rusefi/hellen-miata-NB1/README.md

# Hellen NB1 Miata

Issues are tracked publicly at https://github.com/rusefi/hellen-NB1-issues

[User Documentation](https://github.com/rusefi/rusefi/wiki/Hellen-NB1)

https://docs.google.com/spreadsheets/d/19Mc_QA4MTJAY1hUR4UMexbdGiqNpH4JARKxWm1VD5KA
