rusefi/hellen-miata-NB1/boards/hellen64_NB1-a/board/hellen64_NB1-a.png

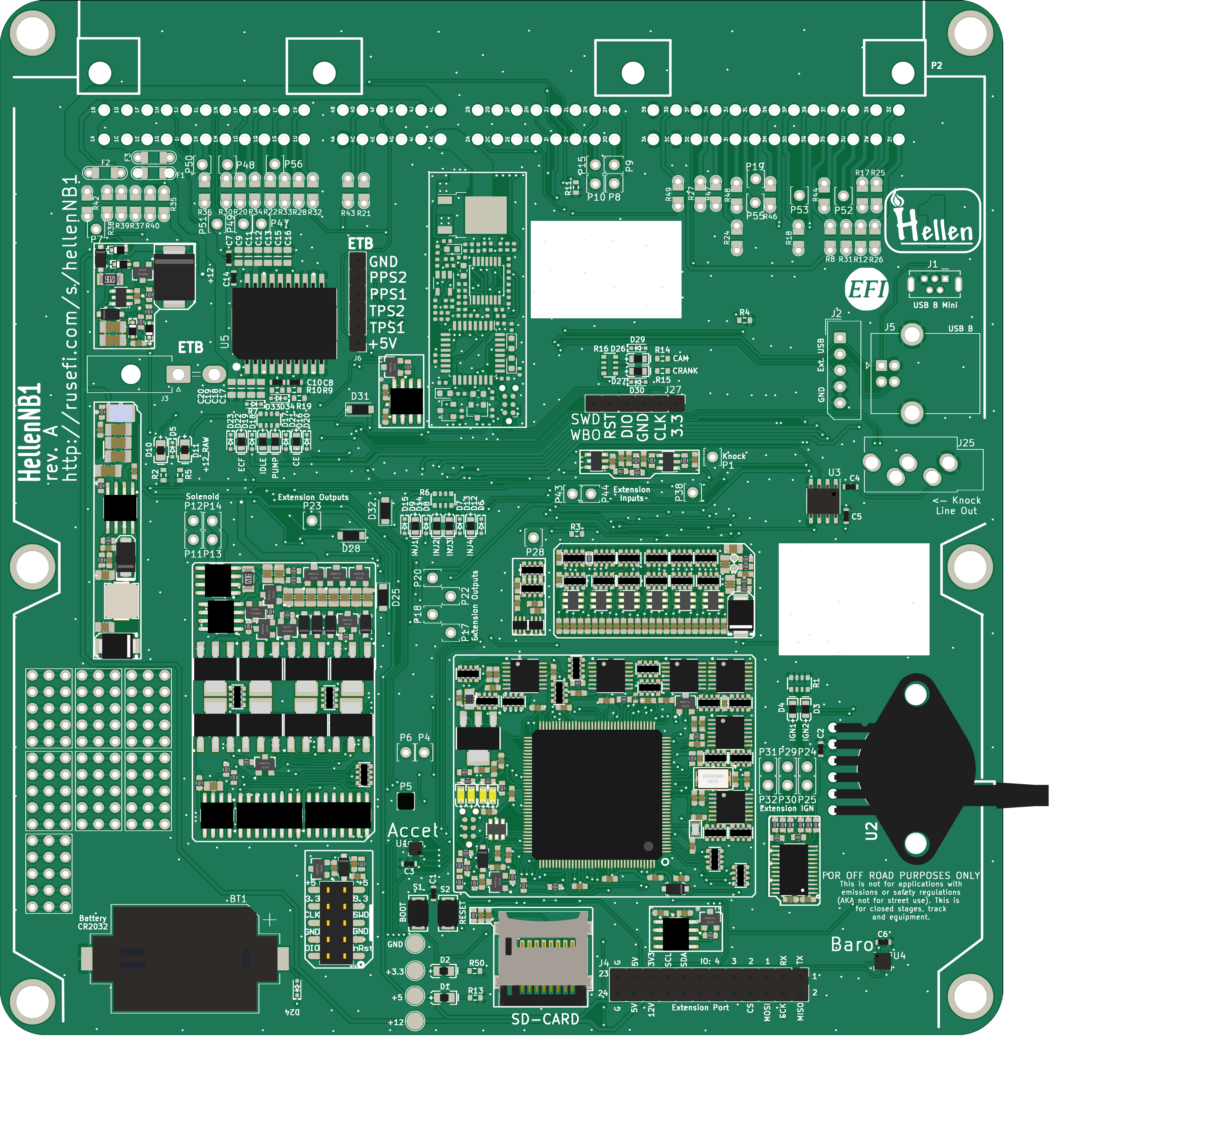
boards/hellen64_NB1-a/board/hellen64_NB1-a.png
