rusefi/hellen-miata-NB1/boards/hellen64_NB1-a/board/misc/hellen64_NB1-a-outline.png

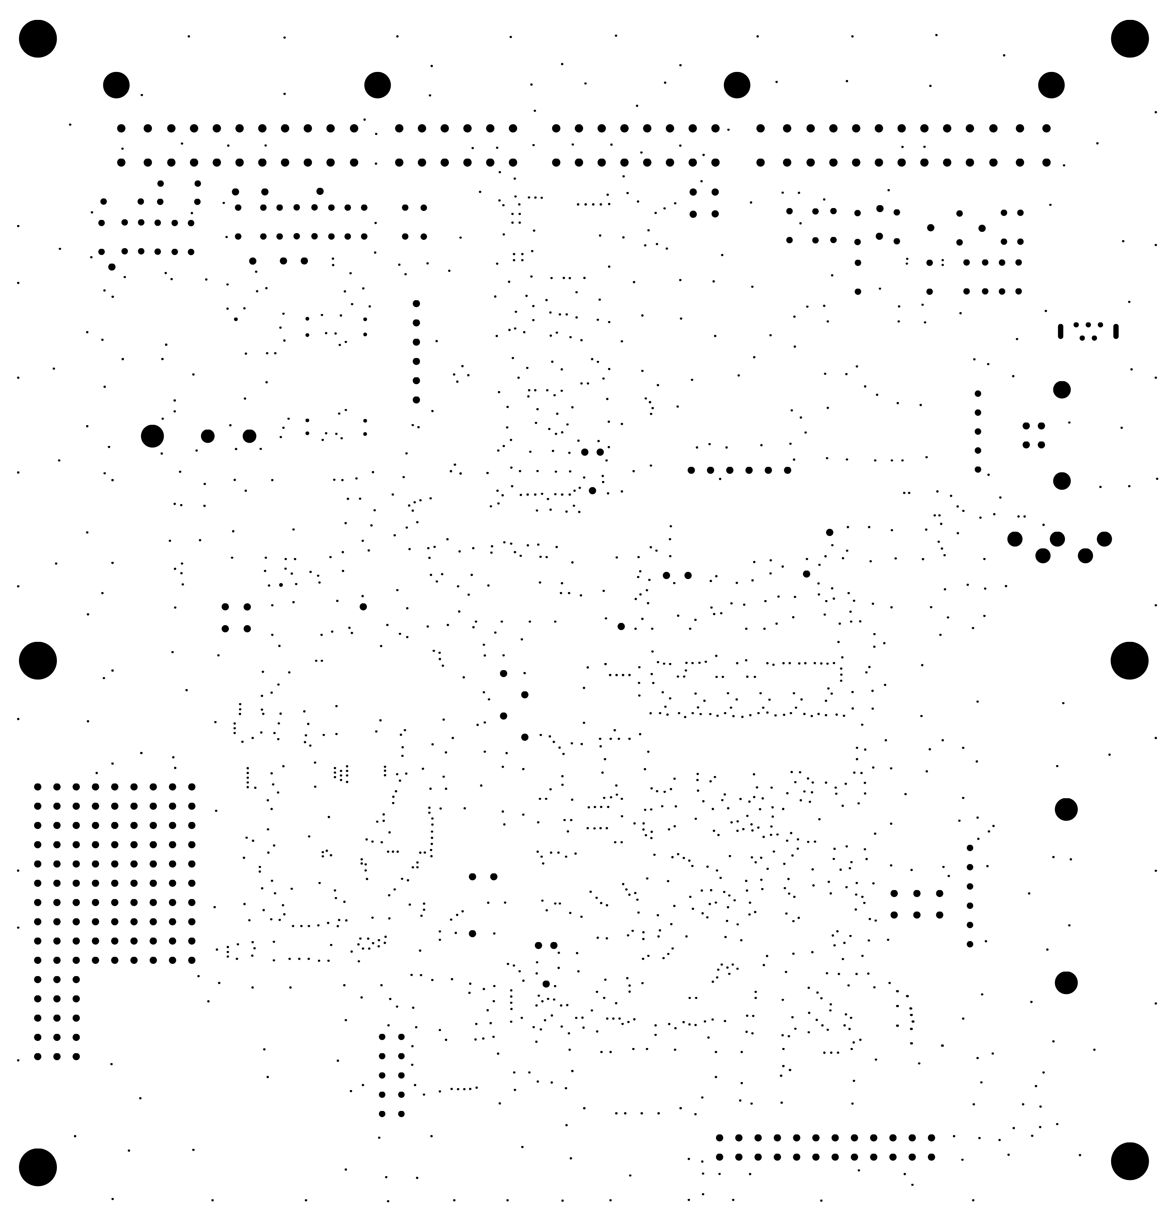
boards/hellen64_NB1-a/board/misc/hellen64_NB1-a-outline.png
