rusefi/hellen-miata-NB1/boards/hellen64_NB1-c/board/hellen64_NB1-c-schematic.pdf

nReset | W5 SWDIO | W6 SWCLK | W7 V33_OUT | W8 M12 Module-wbo-0.3 C²⁰ | 10u | GND
IGN8 | V1 V33 | V10

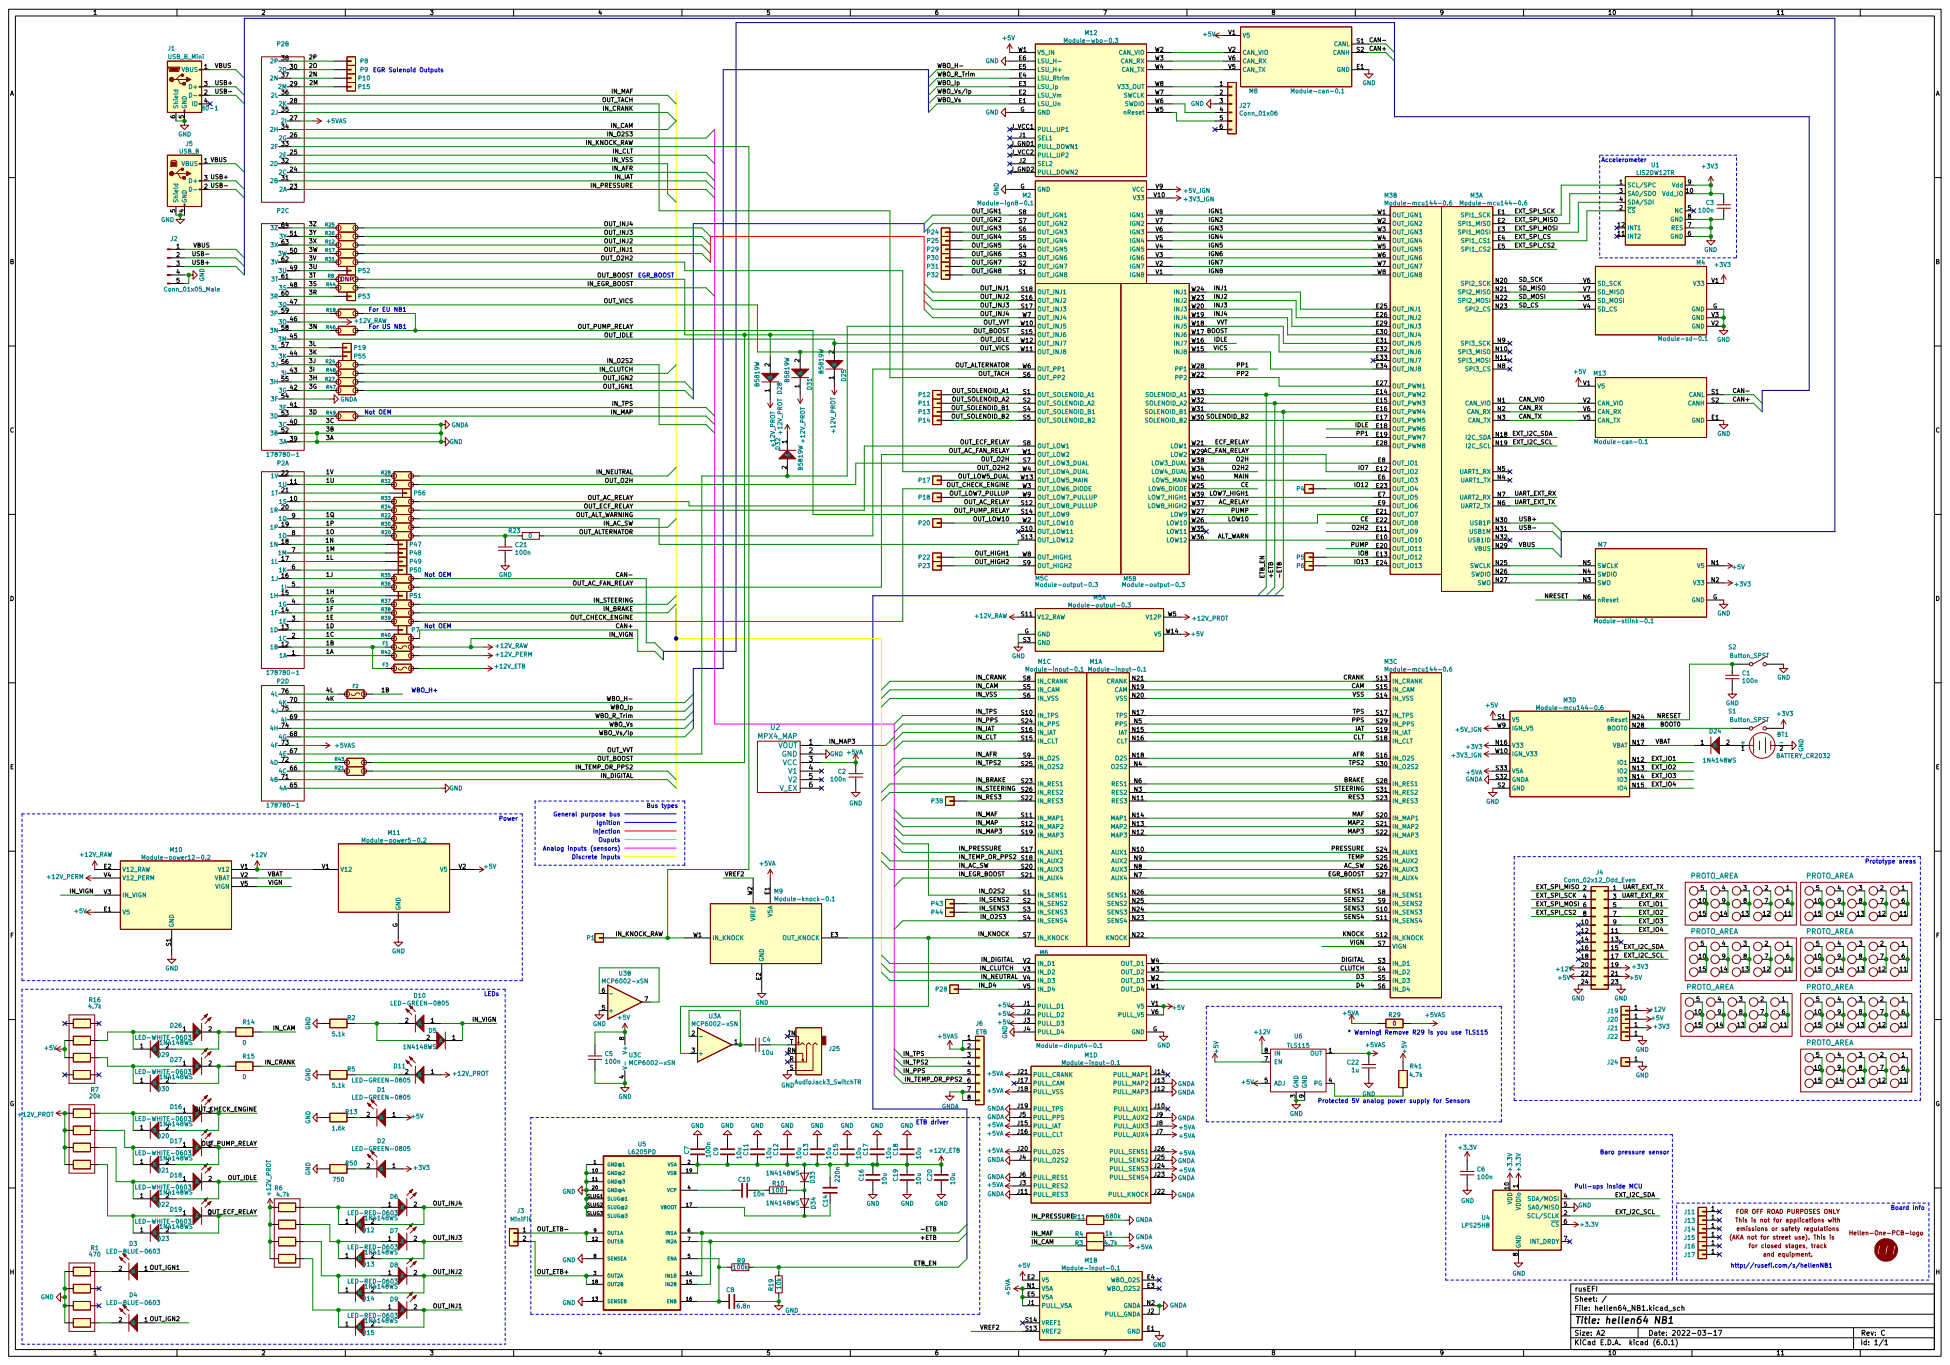
[picture p6: page 1]

For EU NB1 For US NB1 EGR Solenoid Outputs

VBUS USB-USB+ USB- USB+

EXT_I2C_SCL UART_EXT_RX UART_EXT_TX USB+ USB- VBUS MAF MAP2 MAP3 PRESSURE

* Warning! Remove R29 is you use TLS115

This is not for applications with R7

Pull-ups inside MCU

Hellen-One-PCB-logo GND

for closed stages, track FOR OFF ROAD PURPOSES ONLY

emissions or safety regulations
(AKA not for street use). This is

File: hellen64_NB1.kicad_sch Sheet: / rusEFI GND

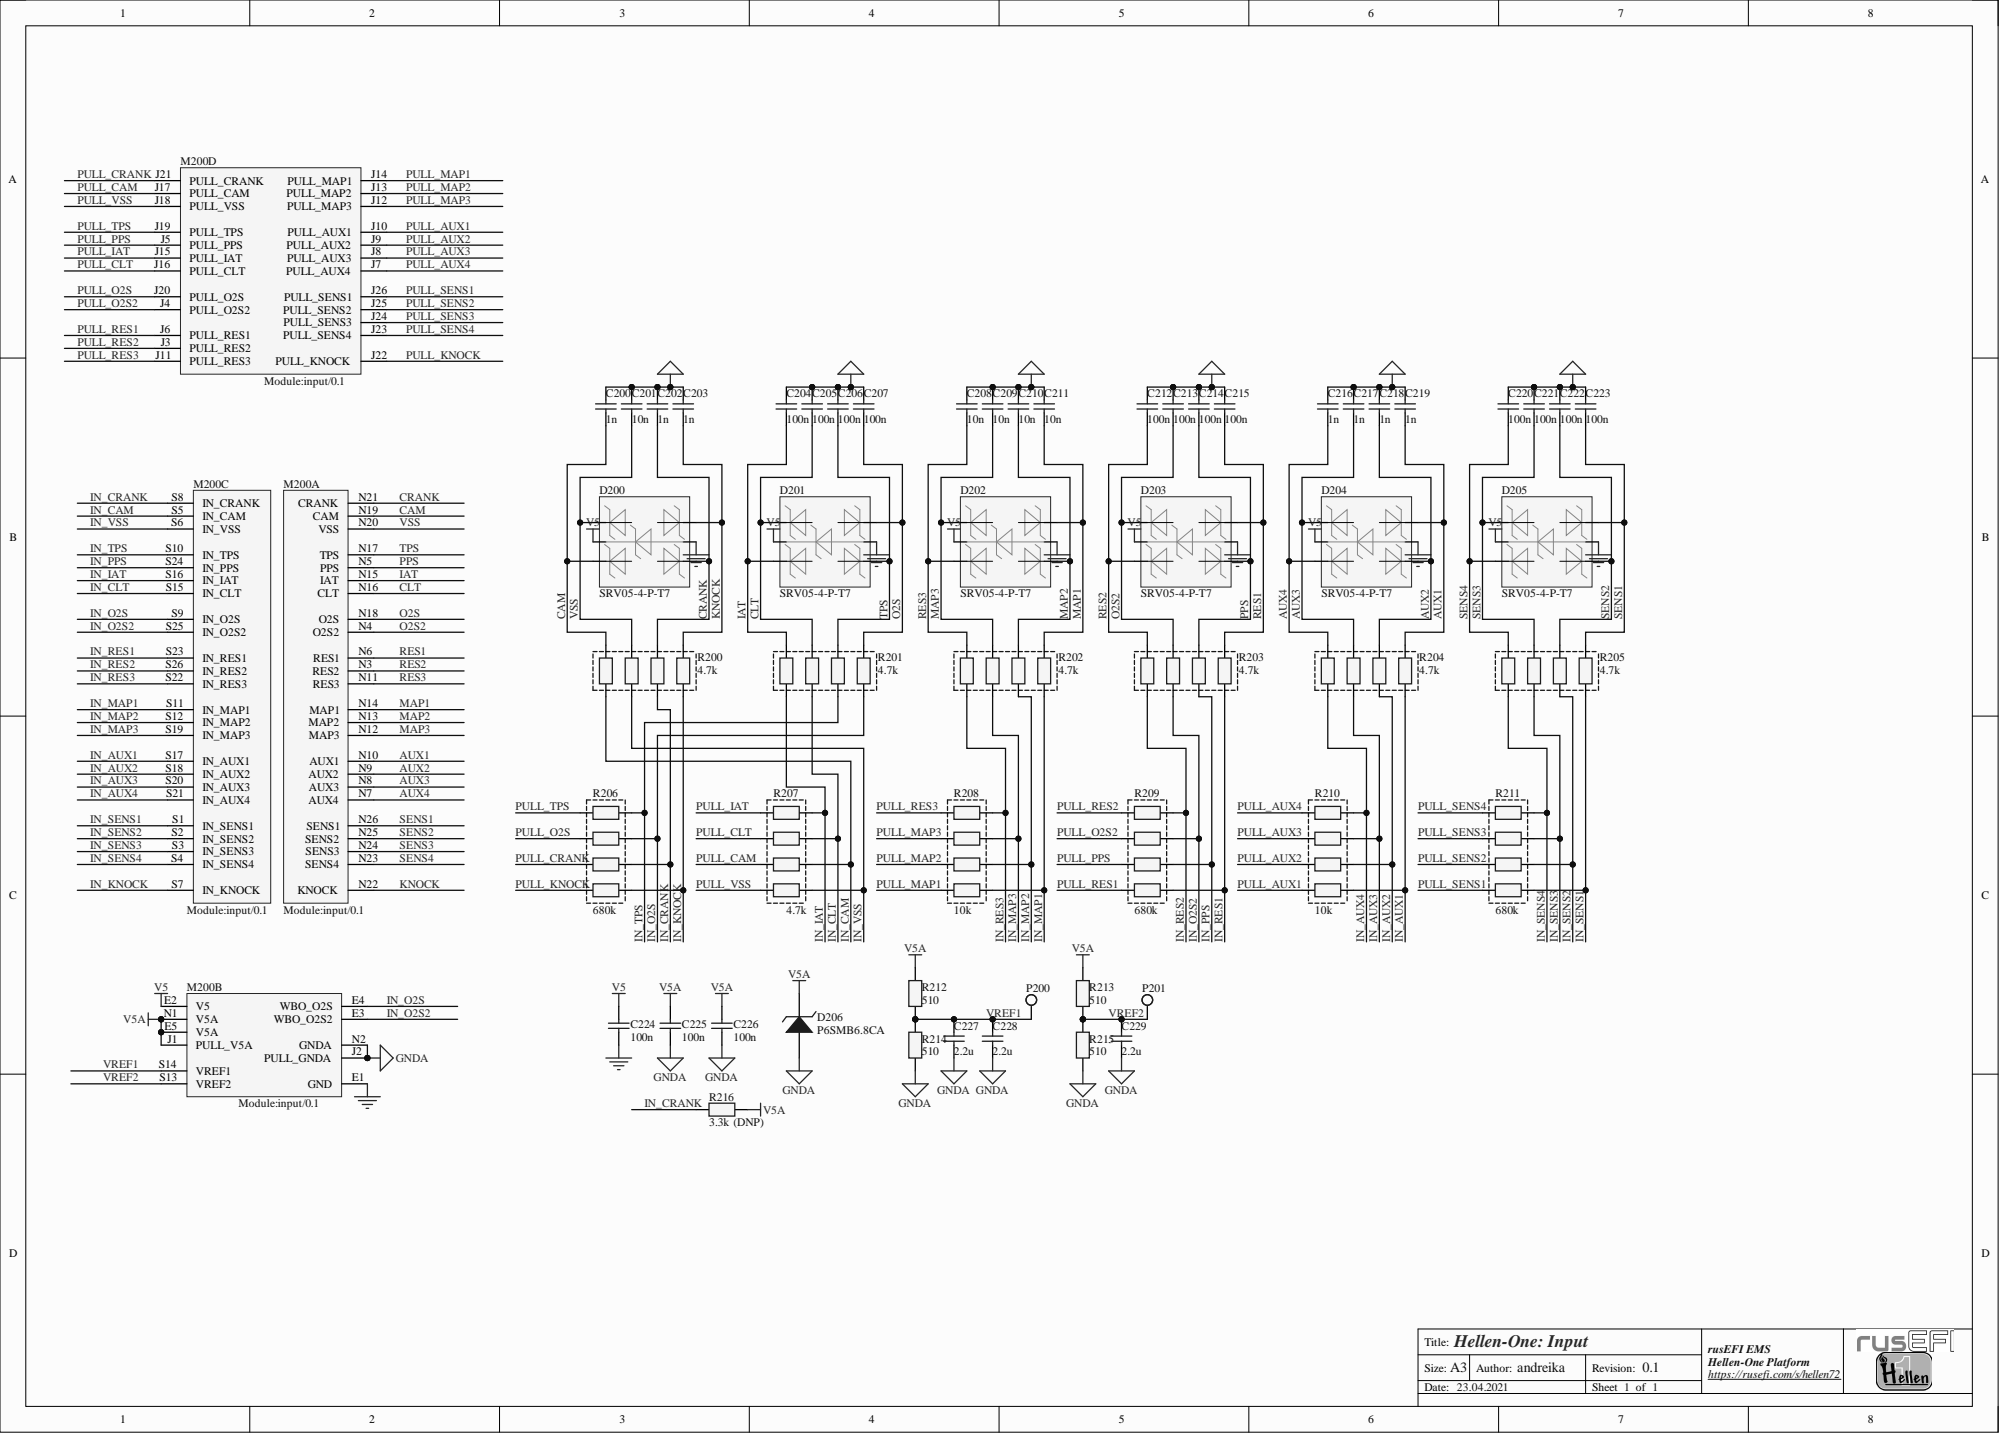
[picture p7: page 2]

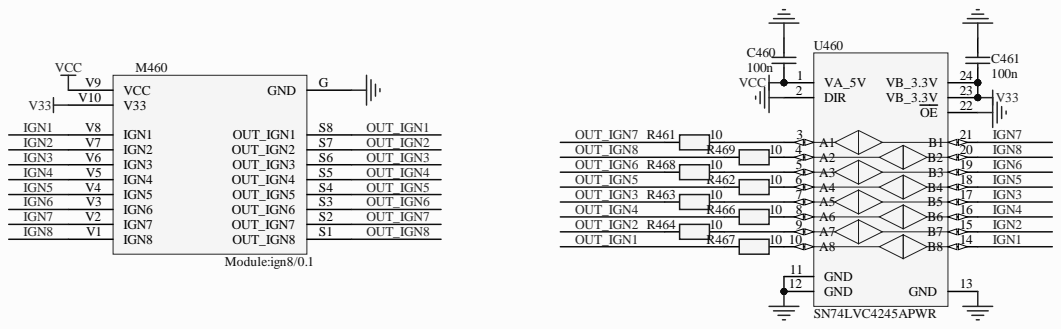
[picture p8: page 3]
tfo rm m/s/h; Size:; Rev; Shee; VCC; APW

Hellen-One IGN8 andreika

rusEFI EMS https://rusefi.co
Hellen-One

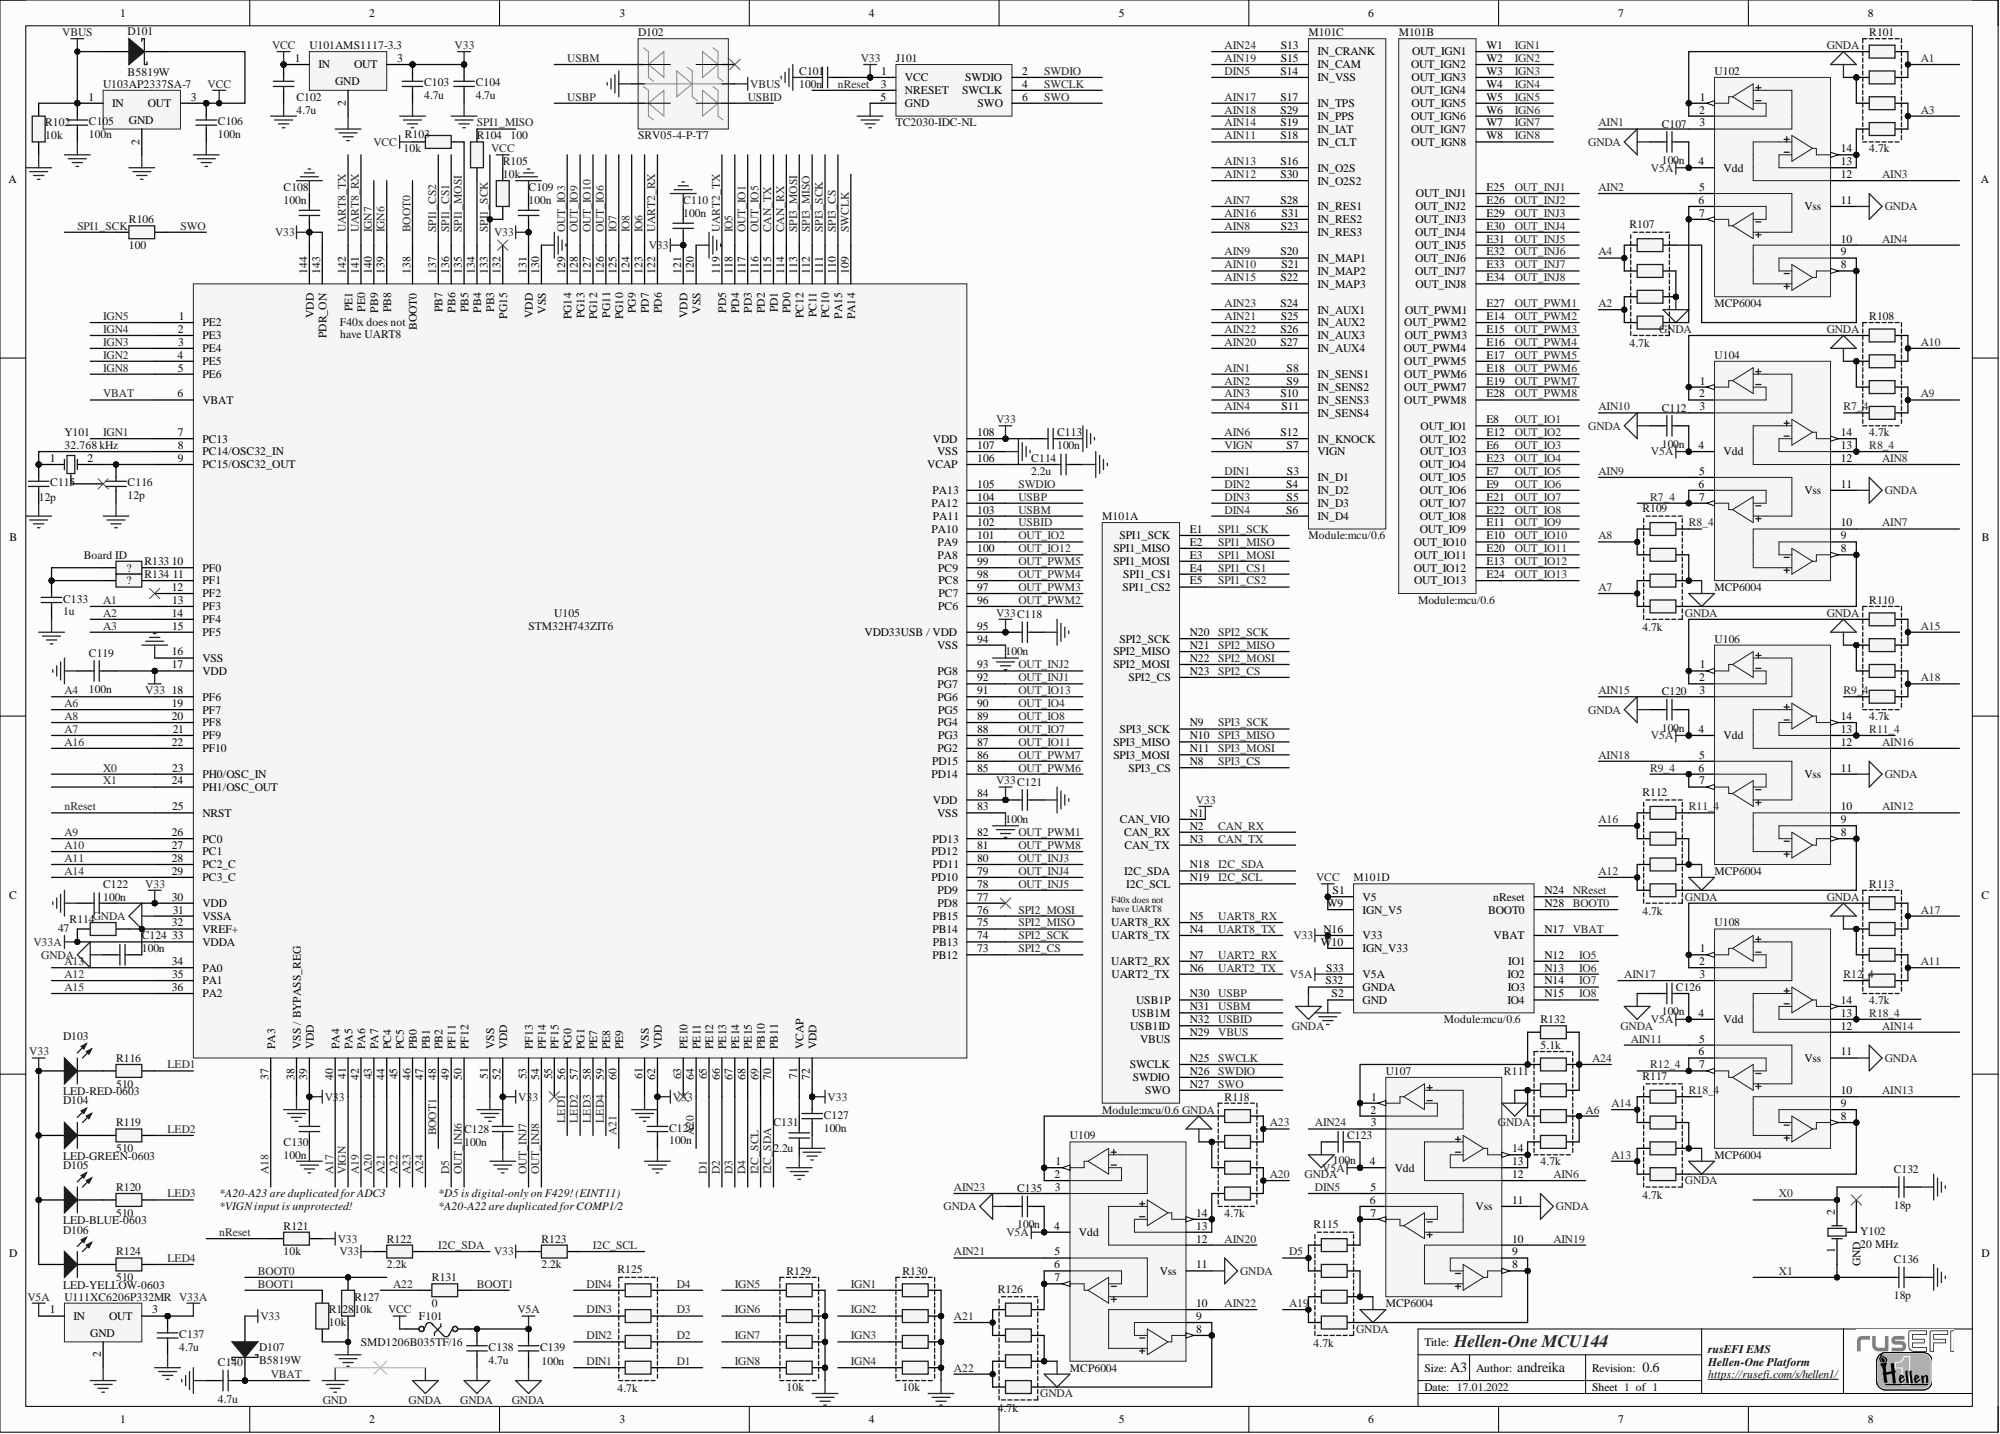
[picture p9: page 4]

D5 *D5 is digital-only on F429!(EINT11)

*A20-A23 are duplicated for ADC3
*VIGN input is unprotected!

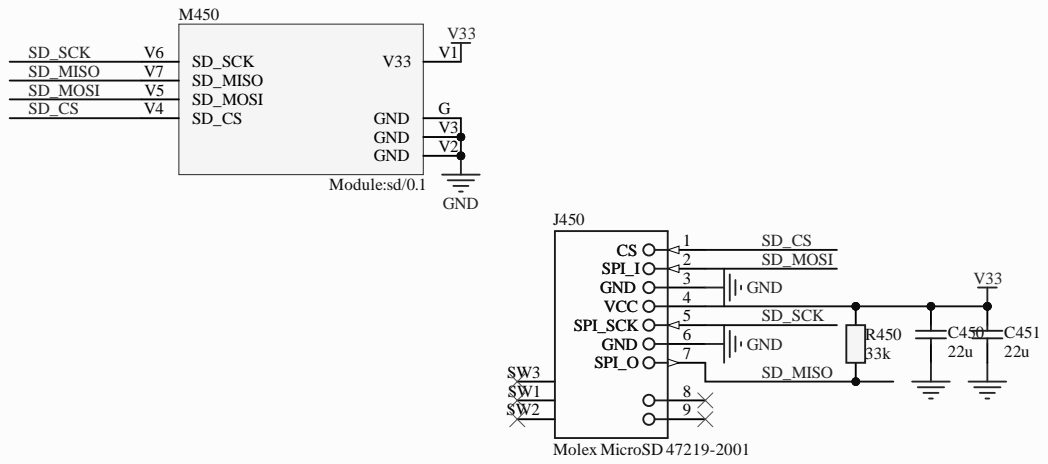
[picture p10: page 5]
2 SPI_I; 3 GND; 4 VCC; 5 SPI_SCK; 6 GND; 7 SPI_O; Molex MicroSD 47219-2001; GND; SD_CS SD_MOSI; SD_SCK; SD_MISO; V2 GND; SD_MOSI V5; SD_SCK V6 SD_MISO V7; Module:sd/0.1; SD_MOSI; SD_SCK SD_MISO

Hellen-One SD-Card

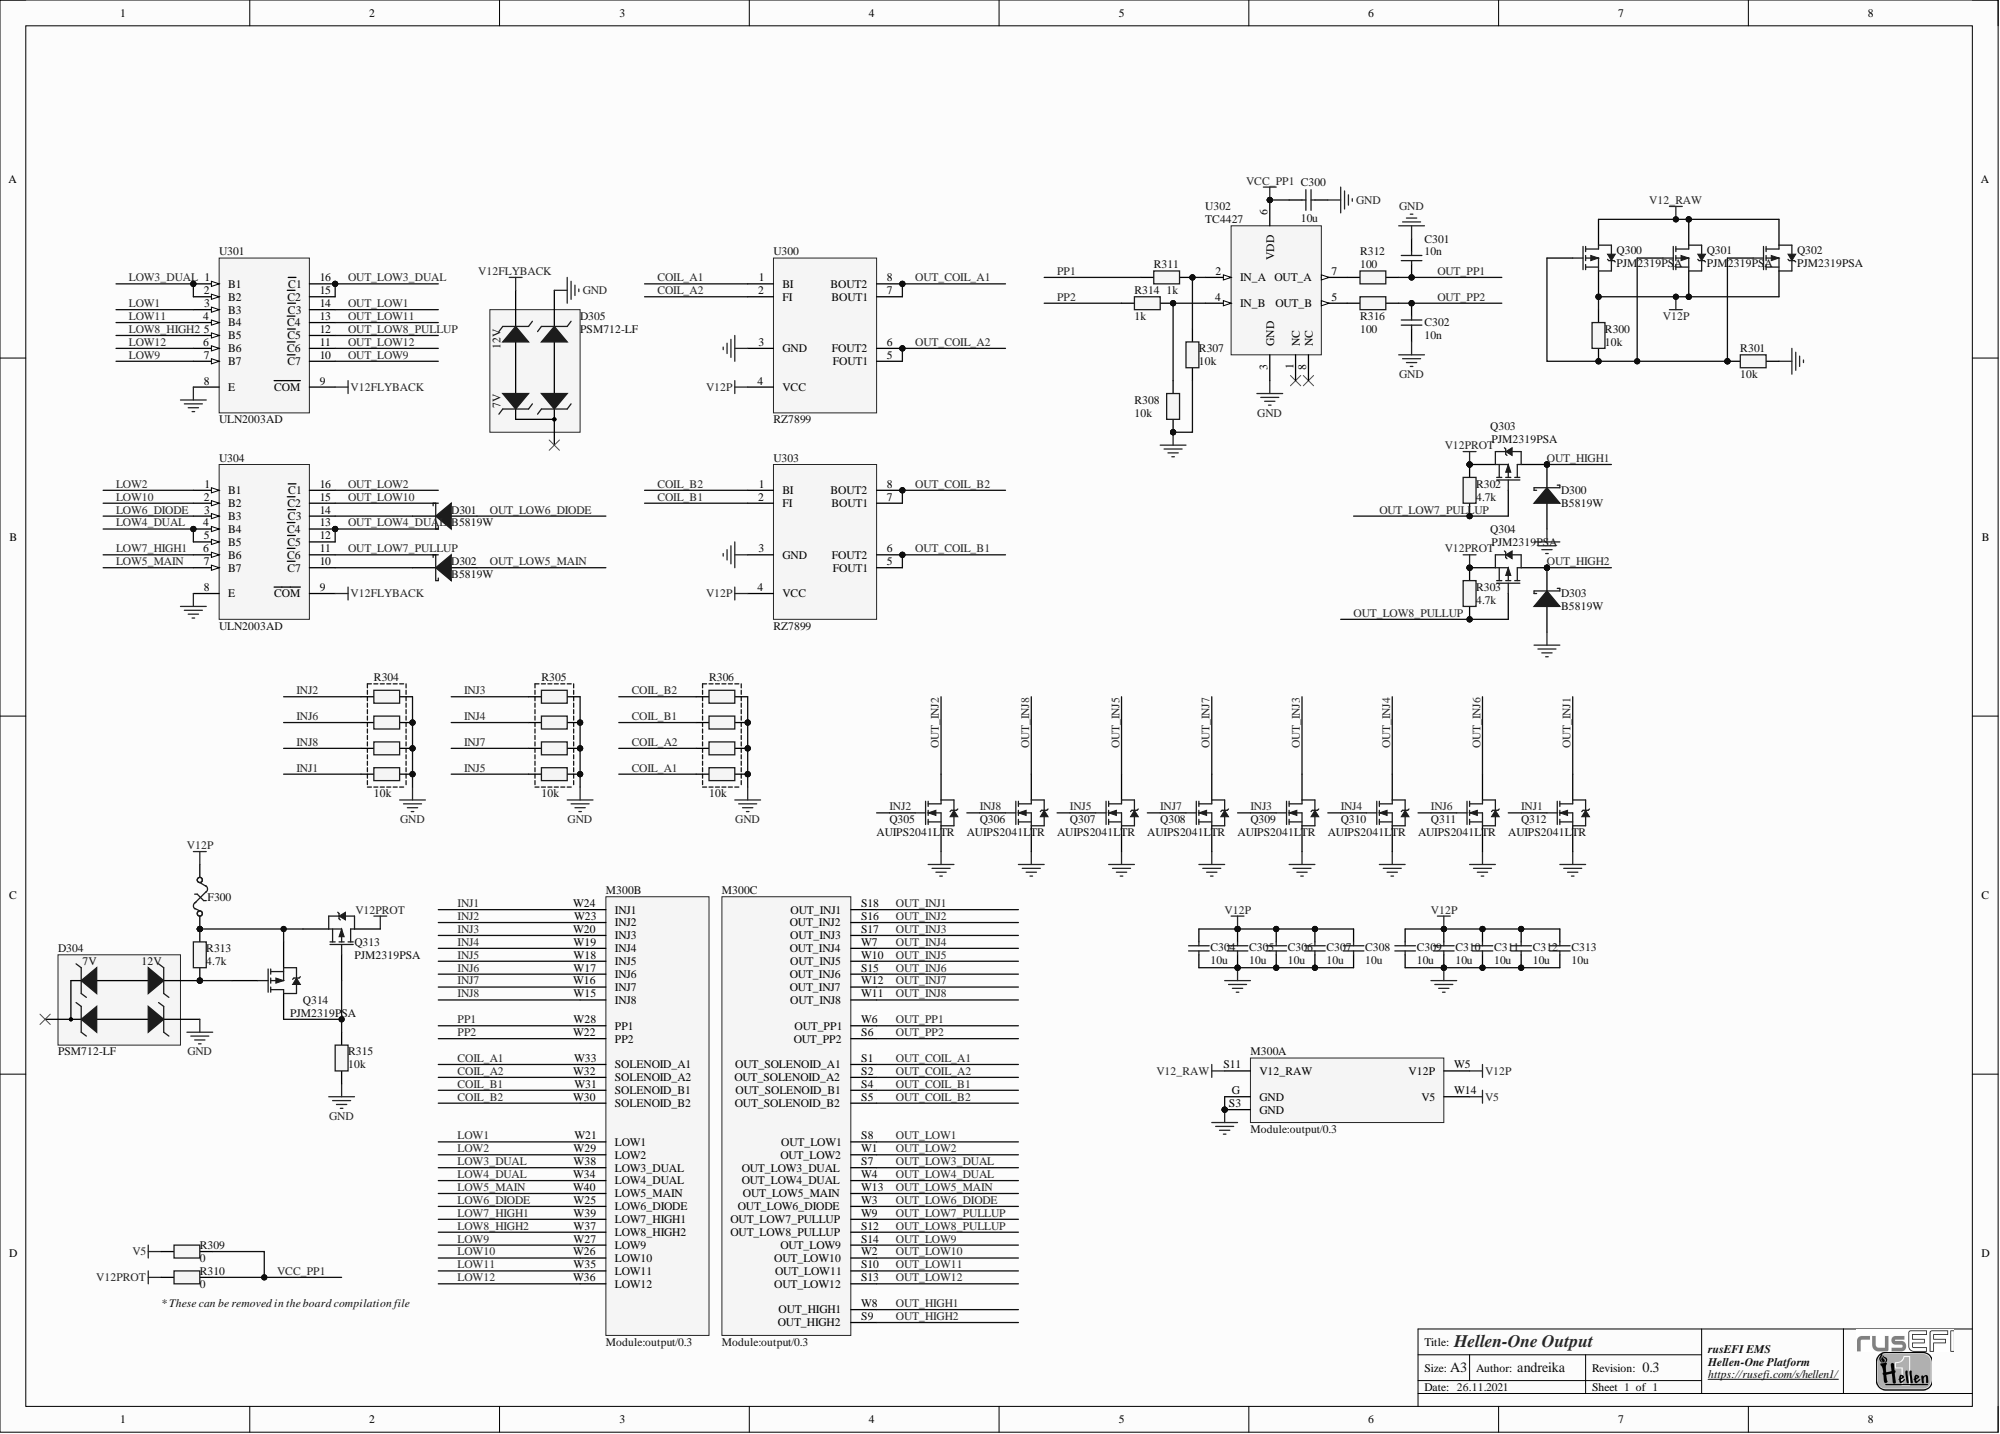
[picture p11: page 6]

* These can be removed in the board compilation file

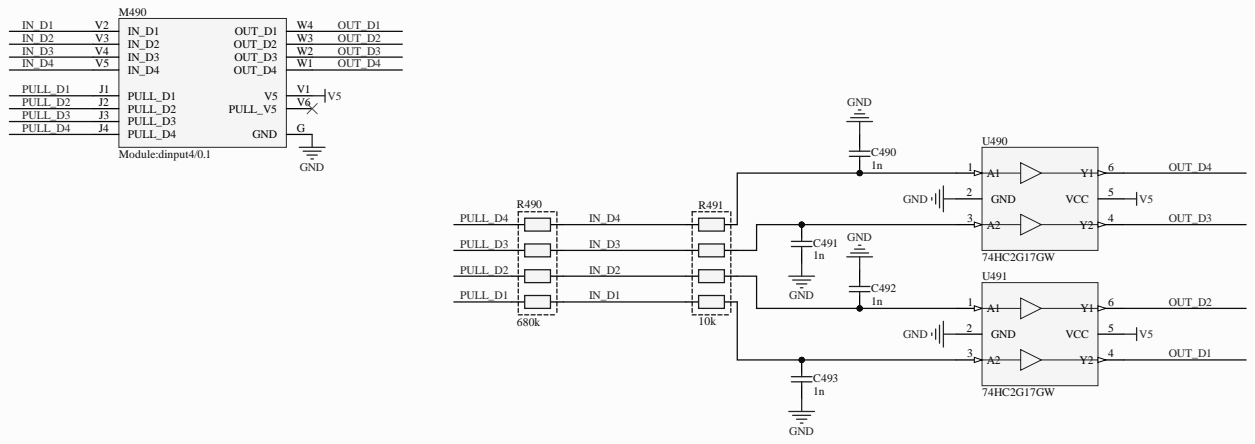
[picture p12: page 7]
tfo rm m/s/h; Size:; Rev; Shee; VCC

Hellen-One VR andreika

rusEFI EMS https://rusefi.co
Hellen-One

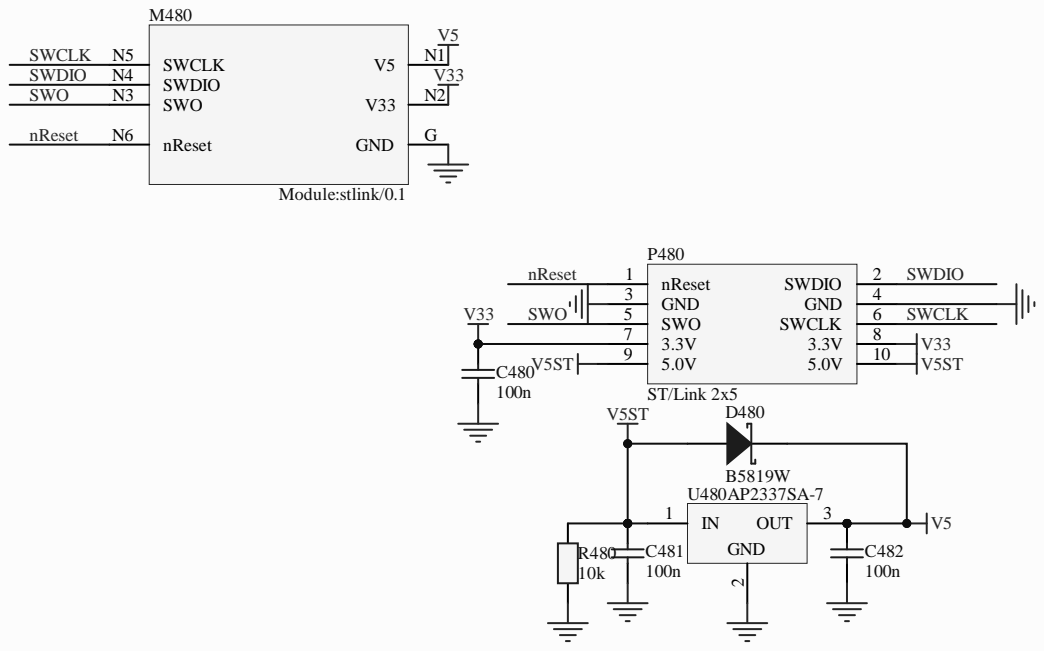
[picture p13: page 8]
nReset 1; SWDIO; GND 3; GND; SWO 5; SWCLK; ST/Link 2x5; nReset; SWO; 2 OUT 3; SWO N3; SWDIO N4; N1 SWCLK N5; nReset N6; Module:stlink/0.1; SWDIO SWO

Hellen-One ST-Link

PESD1CAN; GND; CANH; CANL; TXD 1 GND 2 VCC 3; Vio; 5 RXD 4; 6 CANH; TJA1051T/3/1J; CANH CANL; CAN_TX; CAN_RX; CAN_VIO; CAN_VIO V2; S2 CANL; CAN_TX V5; CAN_RX V6; Module:can/0.1

Hellen-One CAN

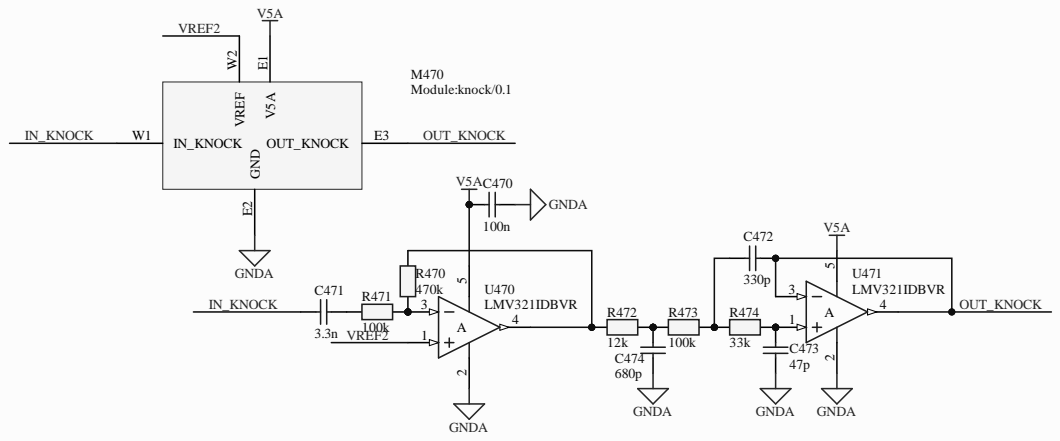
[picture p15: page 10]

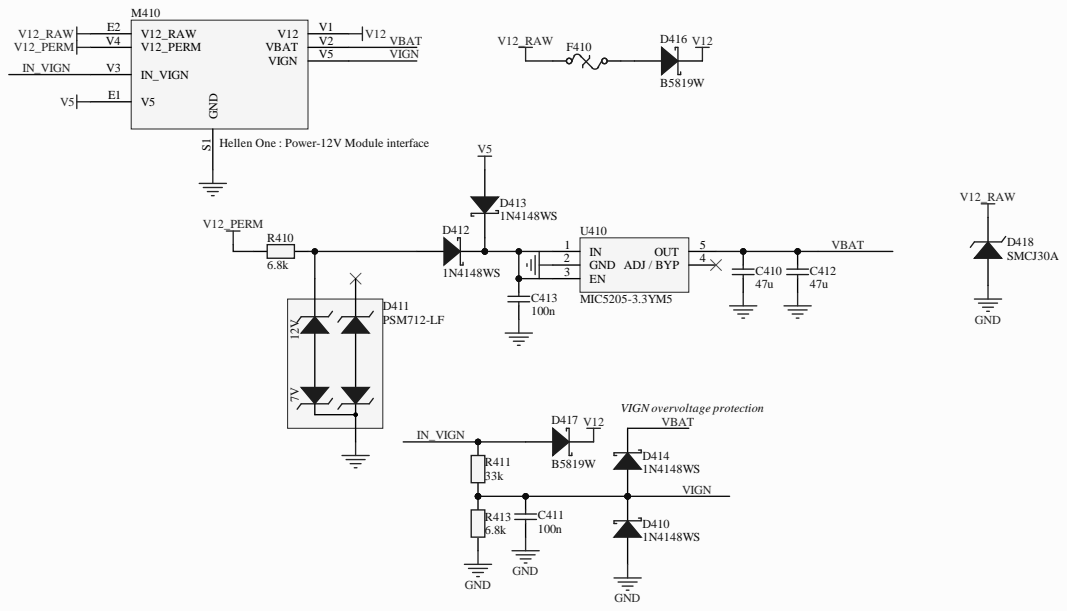
[picture p16: page 11]
tfo rm m/s/h; Hellen-One Power1 2; dreik; Size:; Rev; Shee; VBA; GND S1; Hel; len O; wer-1; terface; VIGN; overvo; tect; 8 SMCJ; 1 PSM7; MIC5

rusEFI EMS https://rusefi.co
Hellen-One

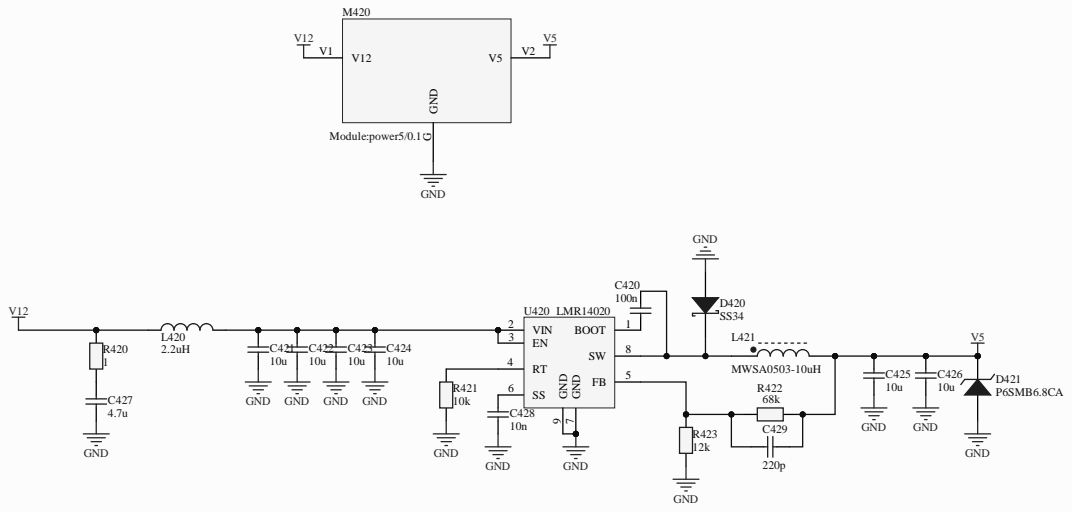
[picture p17: page 12]

1kR600

3.3k R623

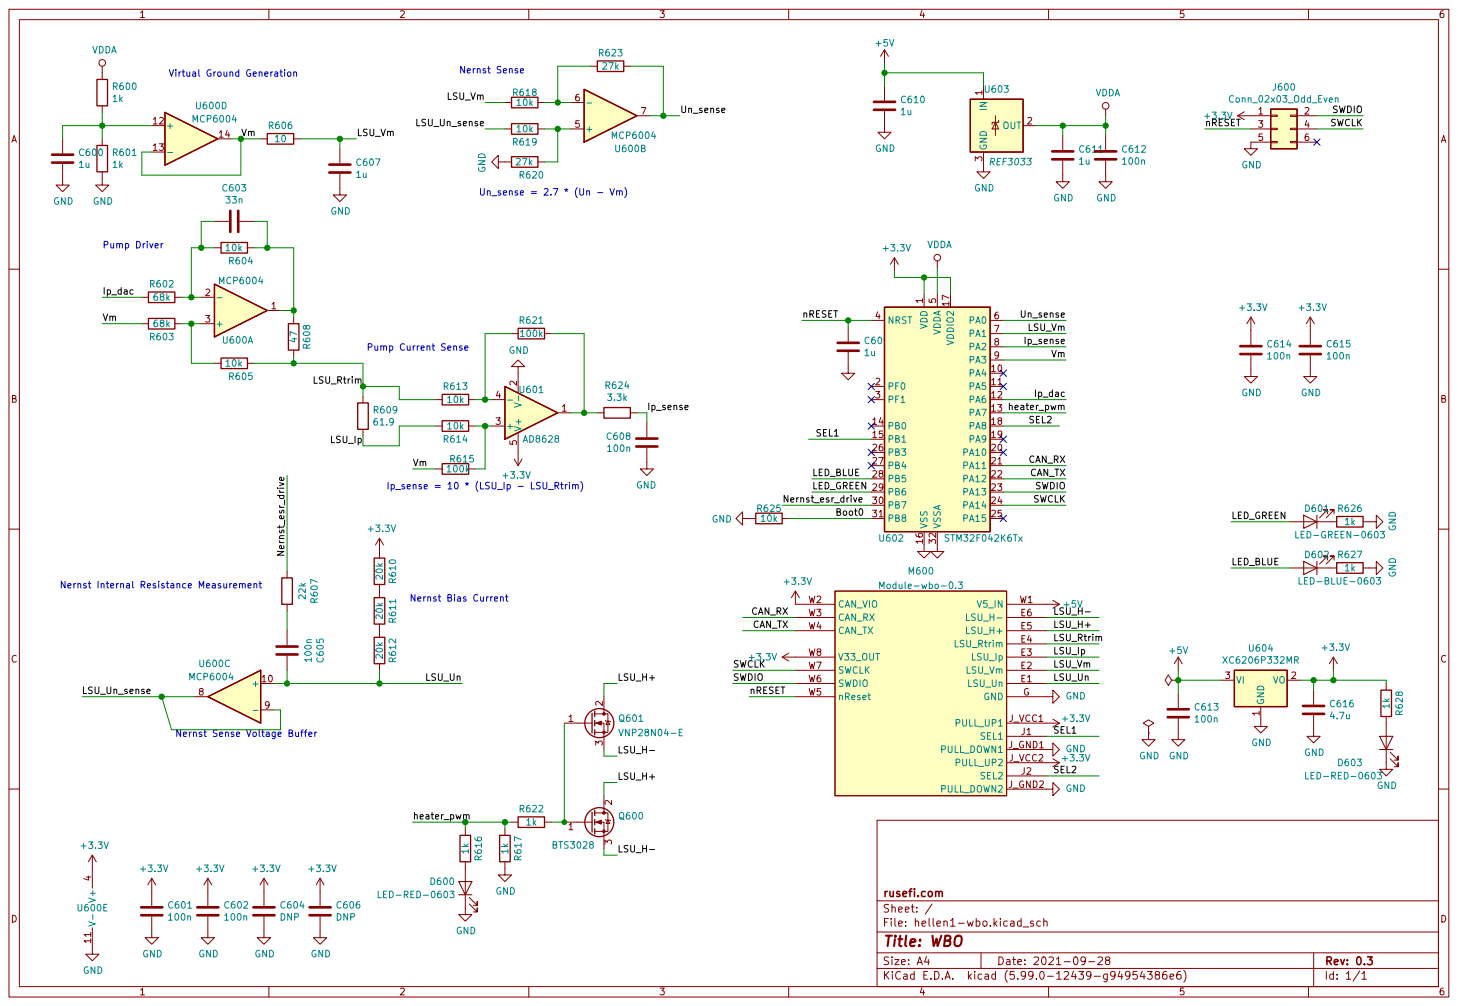
[picture p18: page 13]

Pump Current Sense Nernst Sense

LSU_Vm
Pump Driver Nernst Internal Resistance Measurement

1 VO 2 VI 3 U604 XC6206P332MR GND GND

1 PA4 10 PA5 11 PA6 12 PA7 13 PB0 14 PB1 15 VSS 16 VDDIO2 17 PA8 18 PA9 19 PF0 2 PA10 20 PA11 21 PA12 22 PA13 23 PA14 24 PA15 25 PB3 26 PB4 27 PB5 28 PB6 29 PF1 3 PB7 30 PB8 31 VSSA 32 NRST 4 VDDA

LED-RED-0603 ¹⁰⁰n C⁶⁰⁵ C604 DNP

Nernst Sense Voltage Buffer

1k GND GND R⁶¹⁶ ¹k

File: hellen1-wbo.kicad_sch Sheet: / rusefi.com
