rusefi/hellen-miata-NB1/boards/hellen64_NB1-a/board/hellen64_NB1-a-schematic.pdf

OUT_IO10 E10 OUT_IO9 E11 OUT_IO2 E12 OUT_IO12 E13 OUT_PWM2 E14 OUT_PWM3 E15 OUT_PWM4 E16 OUT_PWM5 E17 OUT_PWM6 E18 OUT_PWM7 E19 OUT_IO11 E20 OUT_IO7 E21 OUT_IO8 E22 OUT_IO4 E23 OUT_IO13 E24 OUT_INJ1 E25 OUT_INJ2 E26 OUT_PWM1 E27 OUT_PWM8 E28 OUT_INJ3 E29 OUT_INJ4 E30 OUT_INJ5 E31 OUT_INJ6 E32 OUT_INJ7 E33 OUT_INJ8 E34 OUT_IO3 E6 OUT_IO5 E7 OUT_IO1 E8 OUT_IO6 E9 OUT_IGN1 W1 OUT_IGN2 W2 OUT_IGN3 W3 OUT_IGN4 W4 OUT_IGN5 W5 OUT_IGN6 W6 OUT_IGN7 W7 OUT_IGN8 W8M3BModule-mcu144-0.5 SPI1_SCK

# E2 SPI1_MOSI E3 SPI1_CS1 E4 SPI1_CS2 E5 CAN_VIO

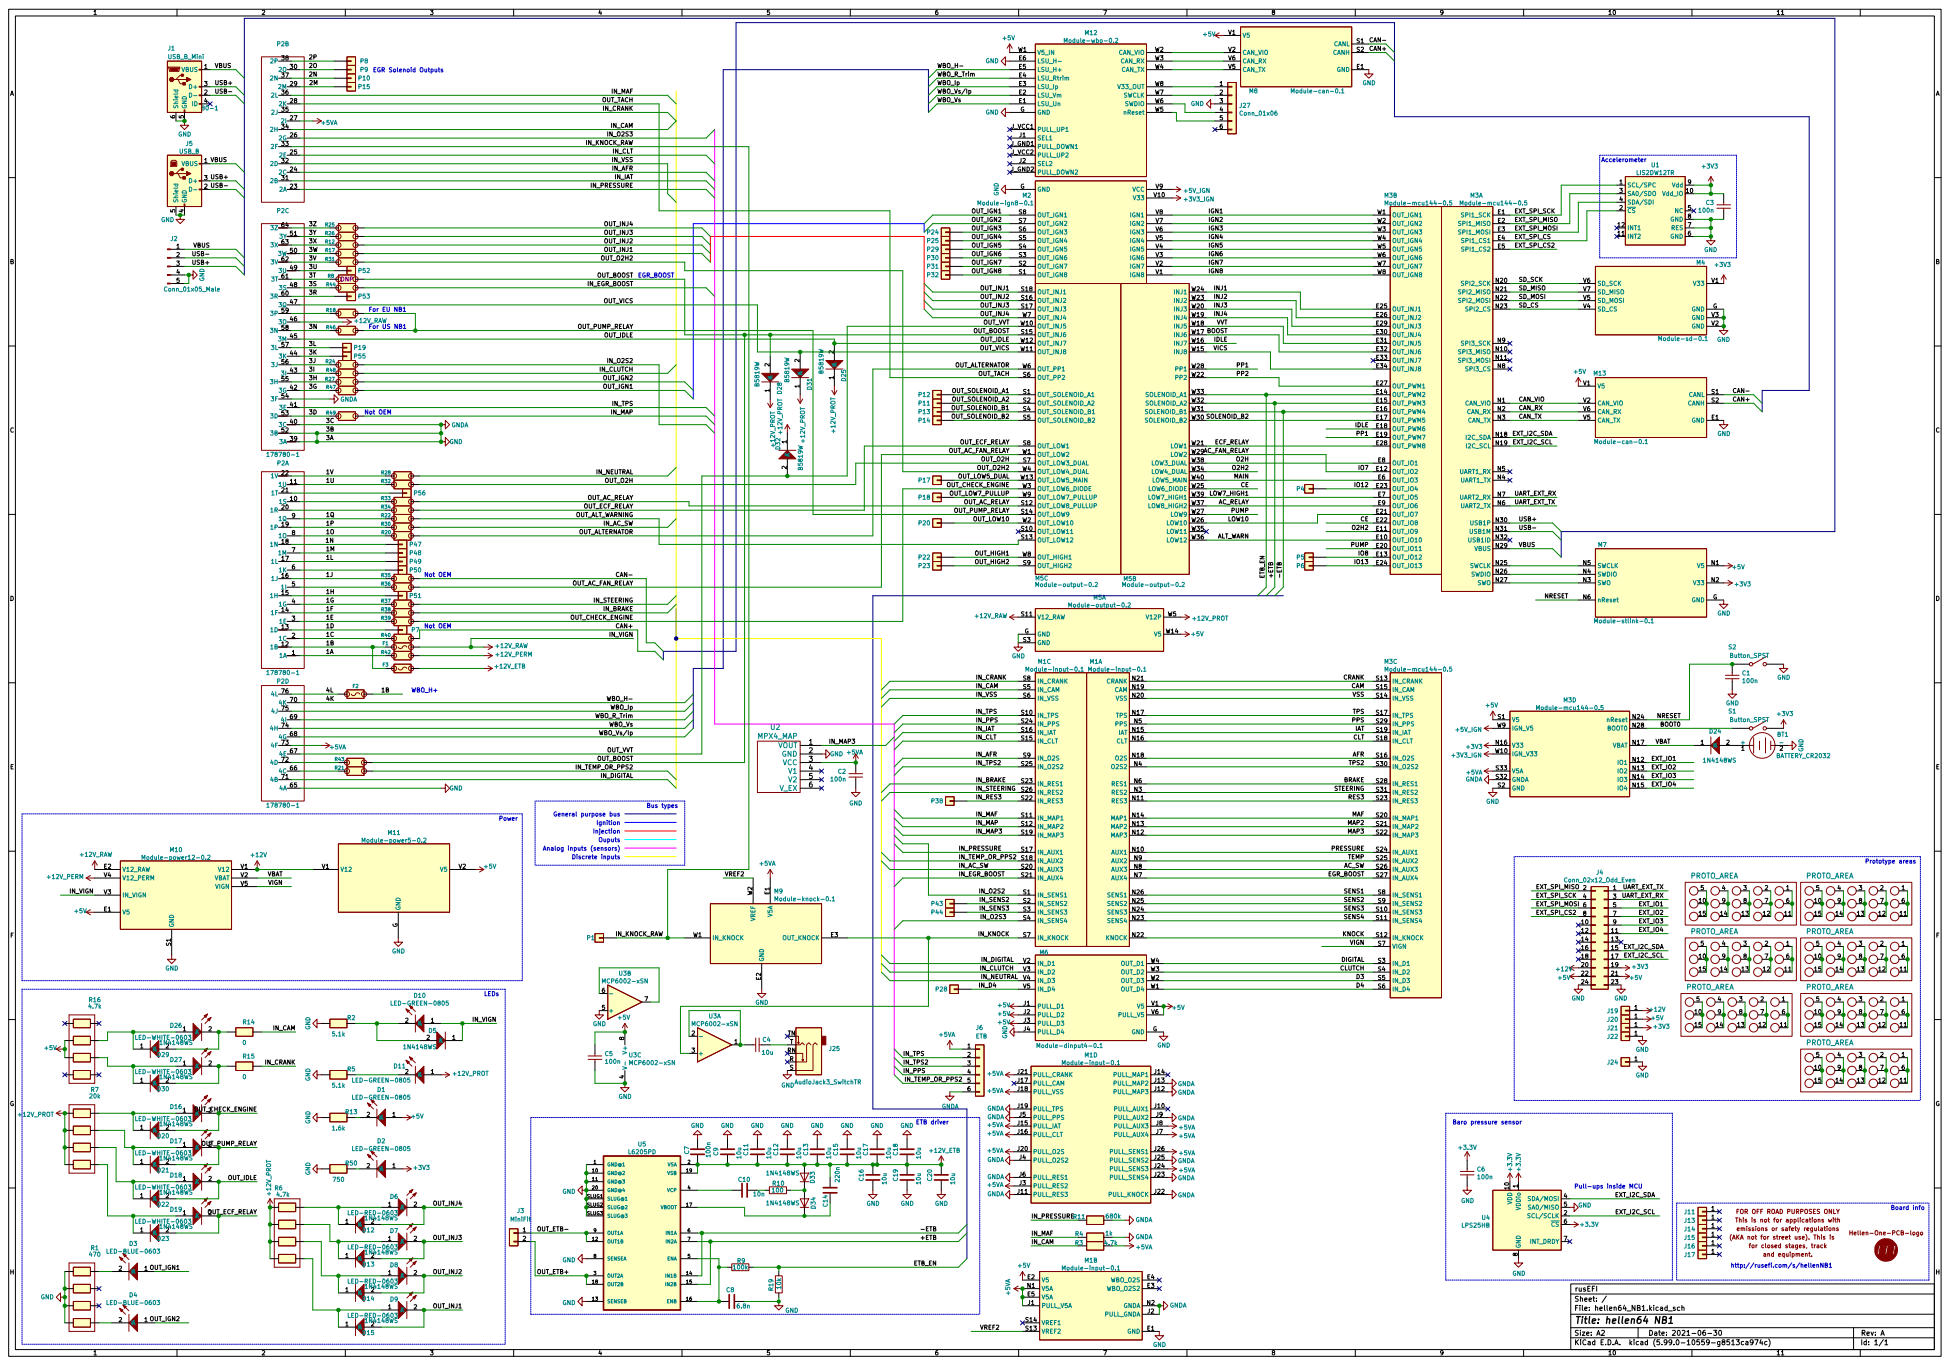
[picture p21: page 1]

For US NB1 For EU NB1
+12V_RAW

Bus types Not OEM

IAT N15 CLT N16 TPS N17 O2S N18 CAM N19 VSS N20 CRANK N21 KNOCK N22 SENS4 N23 SENS3 N24 SENS2 N25 SENS1 N26 RES2 N3 O2S2 N4 PPS N5 RES1 N6 AUX4 N7 AUX3 N8 AUX2 N9 M1AModule-input-0.1 +12V_RAW

Pull-ups inside MCU

for closed stages, track FOR OFF ROAD PURPOSES ONLY
This is not for applications with
emissions or safety regulations
(AKA not for street use). This is

Hellen-One-PCB-logo GND GNDA


tfo rm m/s/h; Size:; Rev; Shee; VCC; APW

Hellen-One IGN8 andreika

rusEFI EMS https://rusefi.co
Hellen-One


D5 *D5 is digital-only on F429!(EINT11)

*A20-A23 are duplicated for ADC3
*VIGN input is unprotected!

2 SPI_I; 3 GND; 4 VCC; 5 SPI_SCK; 6 GND; 7 SPI_O; Molex MicroSD 47219-2001; GND; SD_CS SD_MOSI; SD_SCK; SD_MISO; V2 GND; SD_MOSI V5; SD_SCK V6 SD_MISO V7; Module:sd/0.1; SD_MOSI; SD_SCK SD_MISO

Hellen-One SD-Card

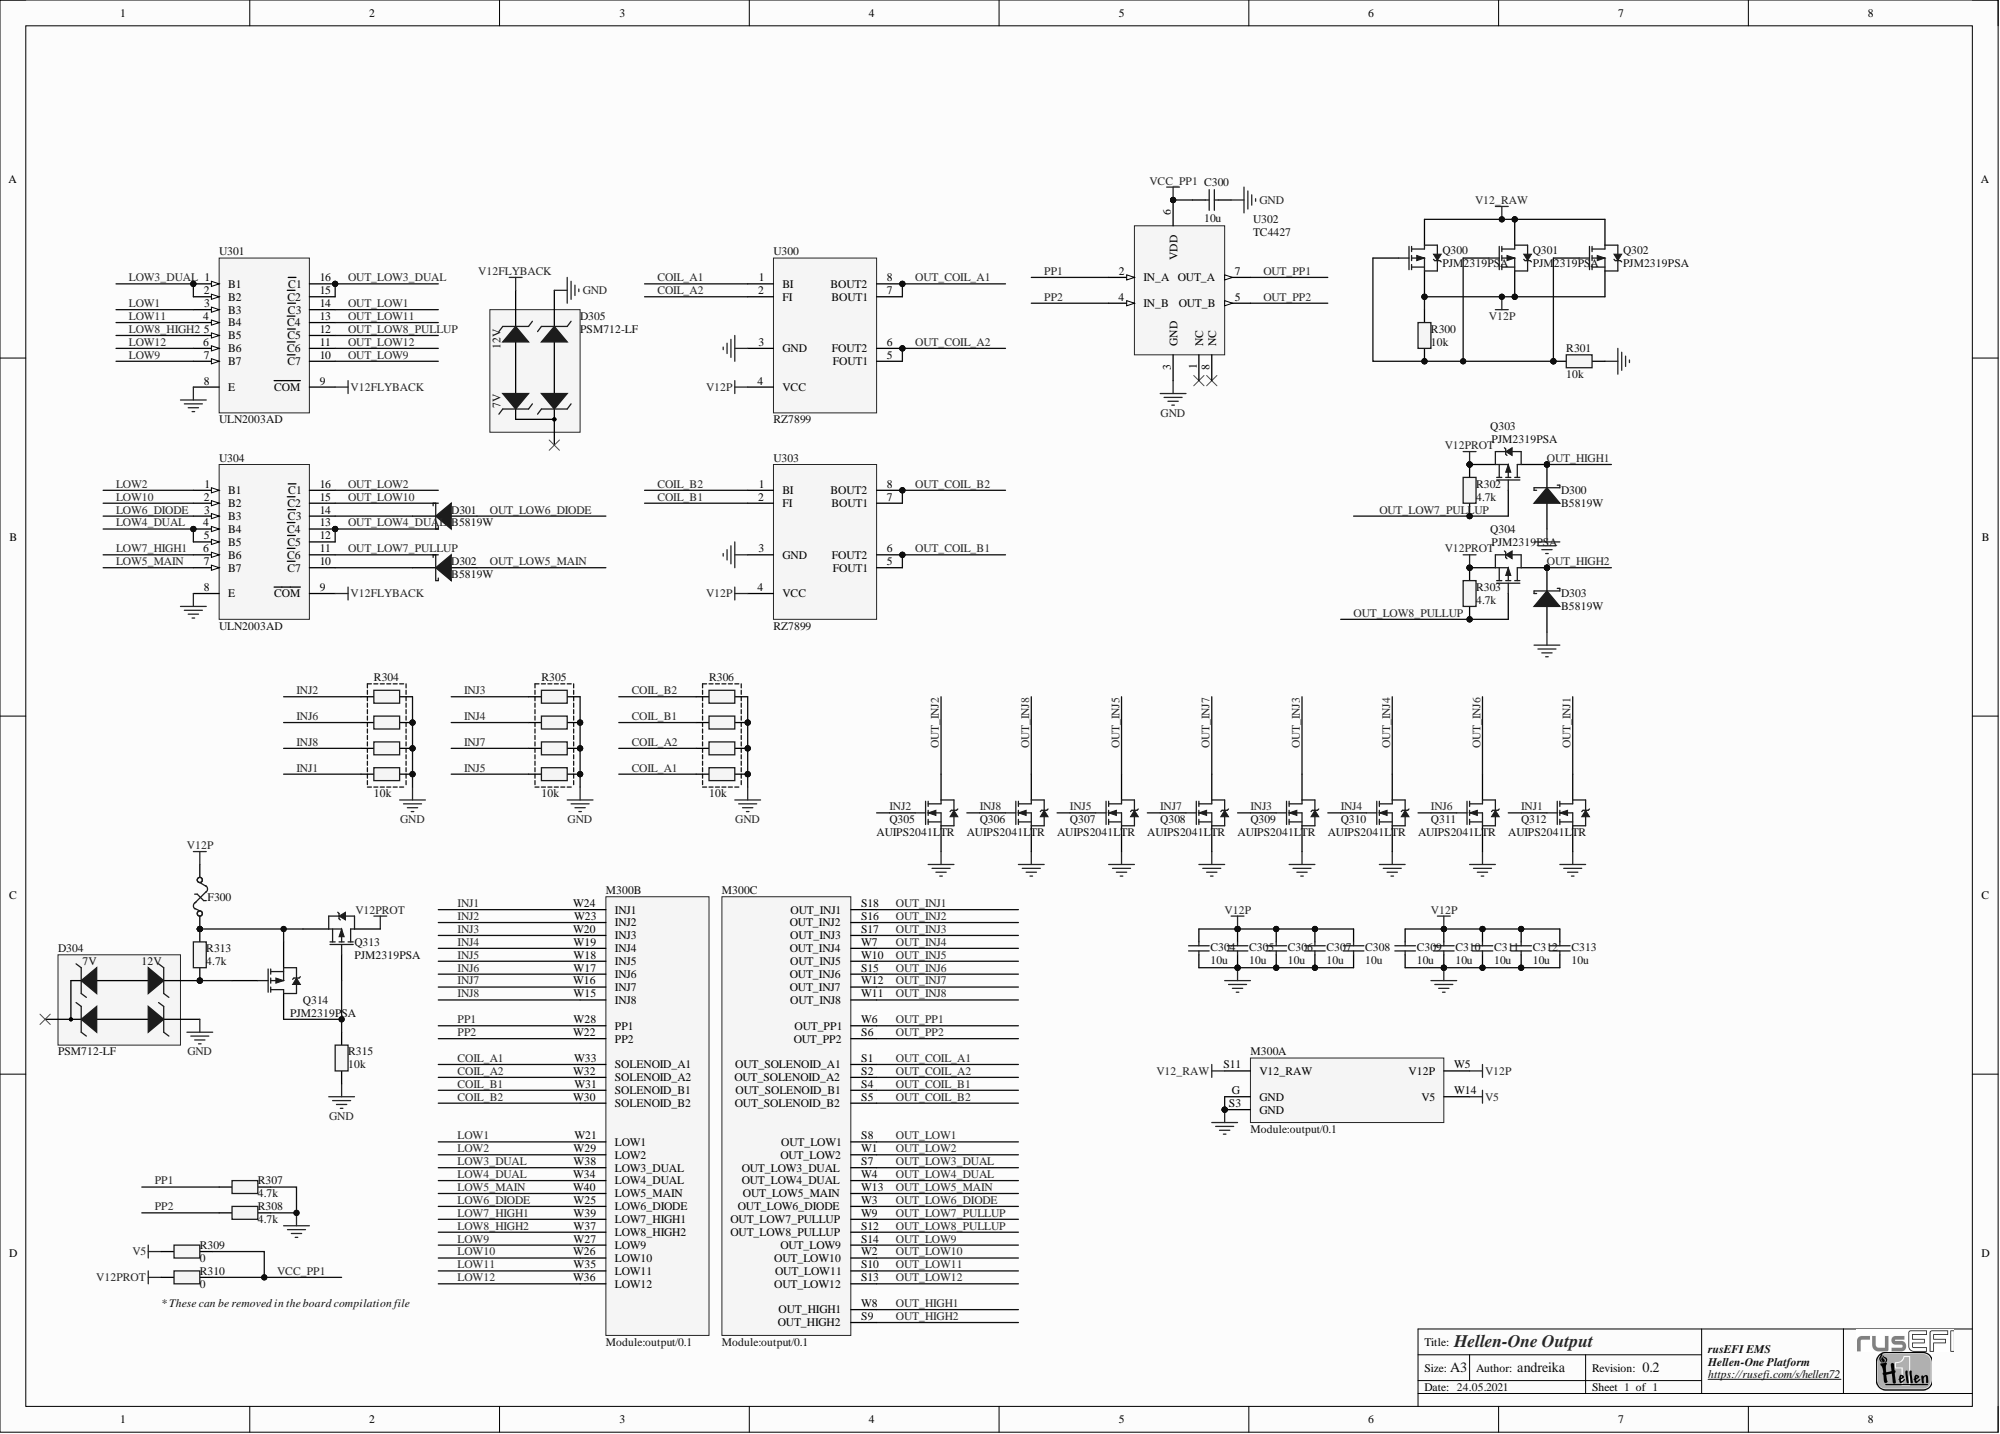
[picture p22: page 6]

* These can be removed in the board compilation file

tfo rm m/s/h; Size:; Rev; Shee; VCC

Hellen-One VR andreika

rusEFI EMS https://rusefi.co
Hellen-One

nReset 1; SWDIO; GND 3; GND; SWO 5; SWCLK; ST/Link 2x5; nReset; SWO; 2 OUT 3; SWO N3; SWDIO N4; N1 SWCLK N5; nReset N6; Module:stlink/0.1; SWDIO SWO

Hellen-One ST-Link

PESD1CAN; GND; CANH; CANL; TXD 1 GND 2 VCC 3; Vio; 5 RXD 4; 6 CANH; TJA1051T/3/1J; CANH CANL; CAN_TX; CAN_RX; CAN_VIO; CAN_VIO V2; S2 CANL; CAN_TX V5; CAN_RX V6; Module:can/0.1

Hellen-One CAN


tfo rm m/s/h; Hellen-One Power1 2; dreik; Size:; Rev; Shee; VBA; GND S1; Hel; len O; wer-1; terface; VIGN; overvo; tect; 8 SMCJ; 1 PSM7; MIC5

rusEFI EMS https://rusefi.co
Hellen-One


- 9 U600C MCP6004 | R⁶¹² ²⁰k 100n C⁶⁰⁵ +
10k | R620

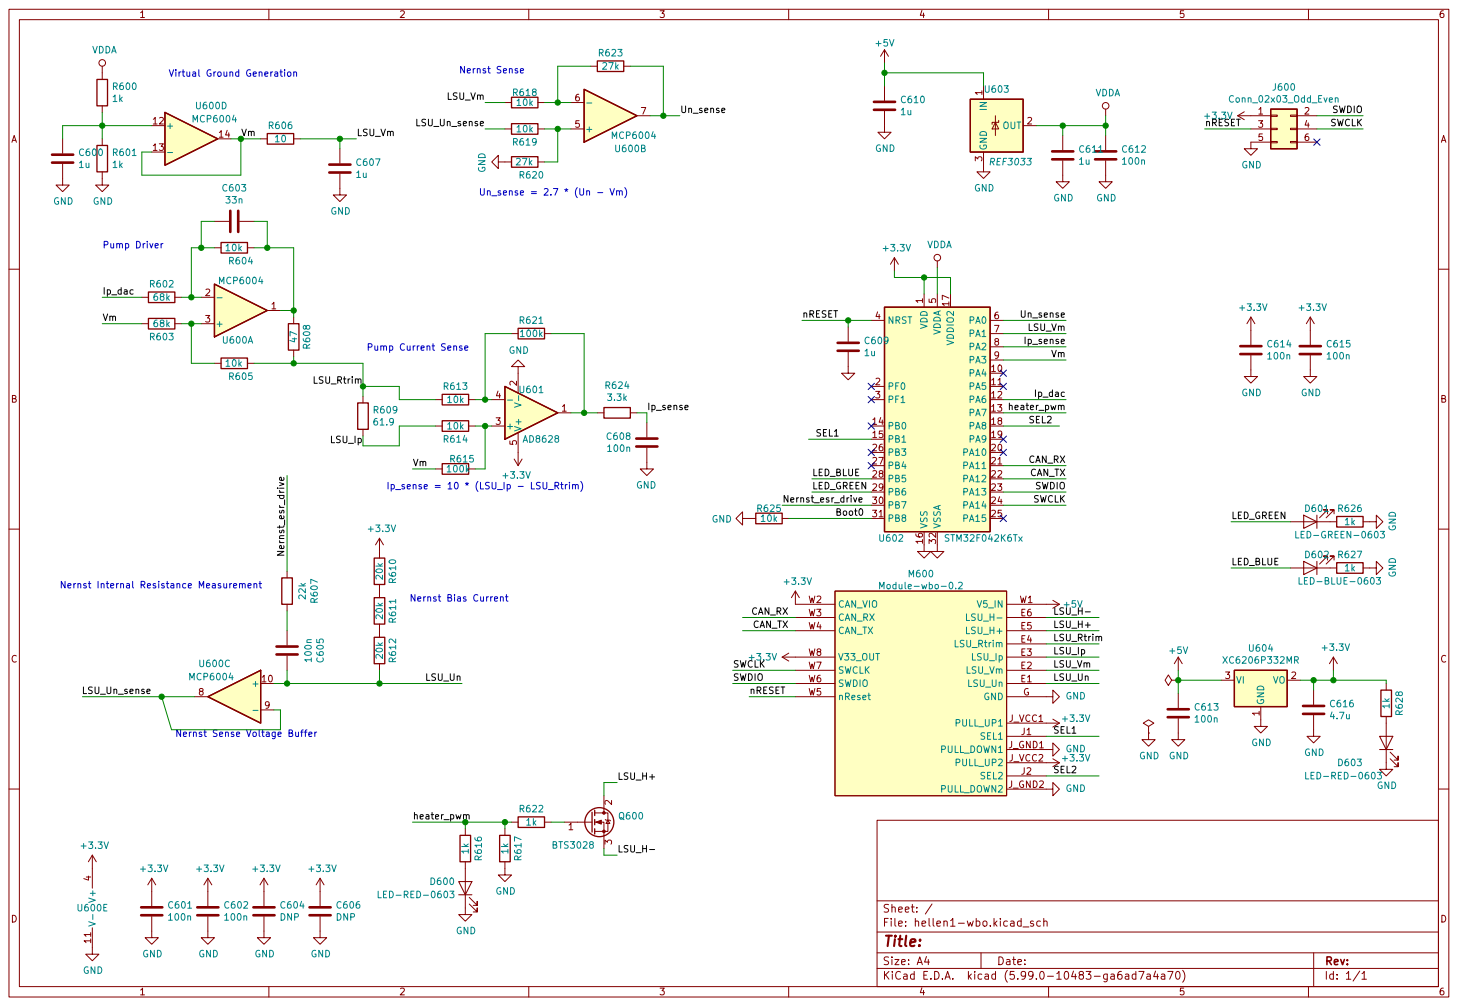
[picture p23: page 13]

Nernst Sense Pump Current Sense Nernst Bias Current Un_sense = 2.7 * (Un - Vm) Virtual Ground Generation Nernst Sense Voltage Buffer

1 PA4 10 PA5 11 PA6 12 PA7 13 PB0 14 PB1 15 VSS 16 VDDIO2 17 PA8 18 PA9 19 PF0 2 PA10 20 PA11 21 PA12 22 PA13 23 PA14 24 PA15 25 PB3 26 PB4 27 PB5 28 PB6 29 PF1 3 PB7 30 PB8 31 VSSA 32 NRST 4 VDDA

1k +3.3V GND GND
LSU_Un Nernst Internal Resistance Measurement

1 VO 2 VI 3 U604 XC6206P332MR GND GND R616 1k R617 1k GND GND
