rusefi/hellen-miata-NB1/(commit log)

2021-07-01 initial kicad files
    [bom_replace_64_NB1-a.csv, hellen64_NB1.kicad_pcb, hellen64_NB1.kicad_sch]
2021-07-02 new pcb board shape, dims & holes for NB1 + trying to fit components inside (remove SD-card ext.header)
    [hellen64_NB1.kicad_pcb, hellen64_NB1.kicad_sch]
2021-07-02 export the schematics draft
2021-07-10 New 178780-1 76p connector footprint & board holes
    [hellen64_NB1.kicad_pcb, hellen64_NB1.kicad_sch]
2021-07-17 update schematic
    [hellen64_NB1.kicad_pcb, hellen64_NB1.kicad_sch]
2021-08-18 update schematics - ETB
    [hellen64_NB1.kicad_sch]
2021-09-09 pcb pre-alpha is ready
    [hellen64_NB1.kicad_sch]
2021-09-09 https://github.com/rusefi/hellen-NB1-issues/issues/6 https://github.com/rusefi/hellen-NB1-issues/issues/7
    [hellen64_NB1.kicad_sch]
2021-09-13 board files (rev.A first test)
    [64_NB1-BOM.csv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]
2021-09-14 fix AC_FAN_RELAY
    [64_NB1.DRL, 64_NB1.GBL, 64_NB1.GBO, 64_NB1.GBS, 64_NB1.GKO, 64_NB1.GTL, 64_NB1.GTO, 64_NB1.GTP]
2021-09-15 JLC BOM adjustments
    [64_NB1-BOM.csv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]
2021-09-23 remove fix https://github.com/rusefi/hellen-NB1-issues/issues/13
    [Proto.sch, hw_nb1.sch, pair.sch]
2021-10-21 fix https://github.com/rusefi/hellen-NB1-issues/issues/18
    [bom_replace_64_NB1-b.csv, hellen64_NB1.kicad_sch]
2021-11-26 update to output-0.3 and wbo-0.3
    [64_NB1-BOM.csv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]
2021-11-27 etb connector 6pin->8pin
    [64_NB1-BOM.csv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]
2021-11-27 board files (PARTIAL, no iBom & board-image)
    [hellen64_NB1-b-BOM.csv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]
2022-03-17 rev.C https://github.com/rusefi/hellen-NB1-issues/issues/32 https://github.com/rusefi/hellen-NB1-issues/issues/30 https://github.com/rusefi/hellen-NB1-issues/issues/28 https://github.com/rusefi/helle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
    [board_id_nb1-c.csv, bom_replace_64_NB1-c.csv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]
2022-03-17 rev.C gerbers
    [64_NB1-BOM.csv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]
